iwonder77/ev-battery-interactive/docs/EV_Battery_Interactive.pdf

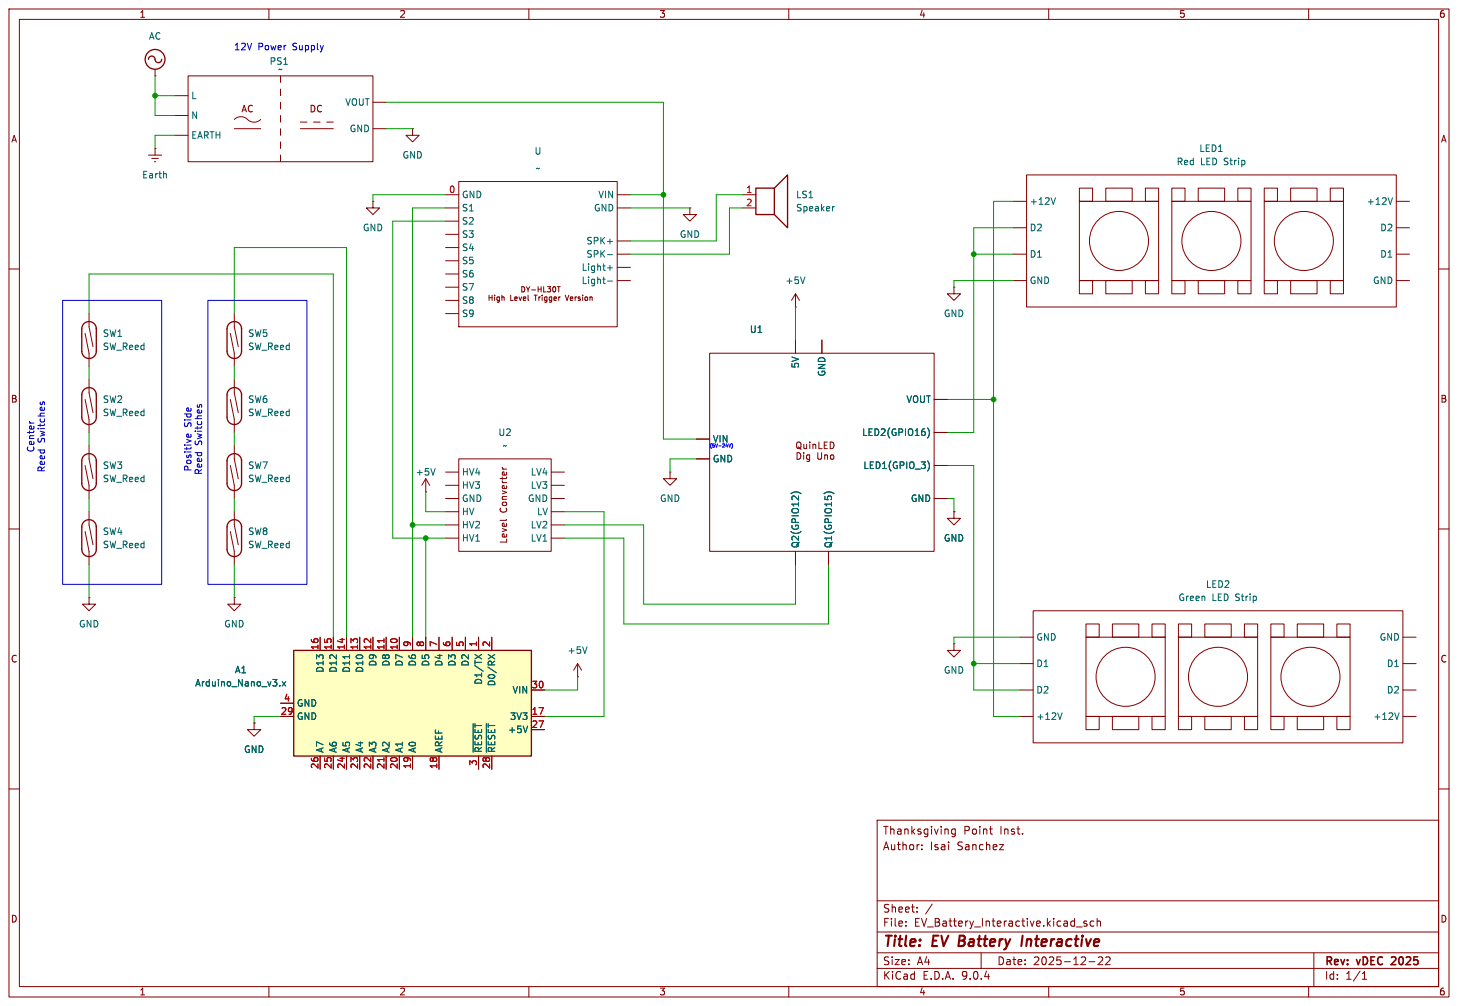
[picture p2: page 1]

Id: 1/1 Title: EV Battery Interactive
