iwonder77/ev-battery-interactive/(commit log)

2025-09-30 lessened LED count for bench test, added animation restart behavior using TIMEOUT for reset cycle/count, added comments, and fixed brightness logic for LEDs
2025-10-10 new yet light restructure of project, we now have a nano that handles reed switch logic so that no high current passes through these switches
2025-10-10 added upload speed parameter because quinled esp32 needs slower upload speed
2025-10-10 reverted back to Mike's og animation code and removed frame timing control for animation because that was a little buggy
    [quinled.ino]
2025-10-13 remapped pins for reed switches and played around with delay, still needs some small tweaking, might add state machine if necessary/have time to do so
2025-10-13 optimized animation logic for sliding window and added glowing red animation for second LED strip that shows the default animation and the red glowing animation
2025-10-14 blocking delay() calls removed, state machine added to mitigate misread and other issues, working much better now
    [nano.ino]
2025-10-17 added folder for pro micro mcu that sends pwm signals to a mosfet driver board that dims the 12V quad led modules
2025-10-17 replaced previous green LED strip with WS2815 strip, much more LED count
    [quinled.ino]
2025-10-17 modified CS3x bits in the TCC3RB register to increase PWM frequency, see code for more info
2025-10-20 changed to fast pwm mode
2025-10-20 reversed the direction of the sliding window animation and cleaned it up a bit
    [quinled.ino]
2025-12-12 unused implementation of a backlight dimmer by sending pwm signals to a dual mosfet switch, simply using one purchased online dude I didn't have to make this but it was really informative modifying r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
2025-12-23 add schematic pdf in docs/ folder
2025-12-23 add schematic jpg
2025-12-23 update readme to show schematic image
